mackatack/FCBInfinity/README.md

Behringer FCB1010 modification: FCBInfinity!
===========

This is the home of all the source and schematics for my FCBInfinity project. In this DIY-project I will completely redo the internals of the Behringer FCB1010 midi foot controller. I will add an LCD (Liquid Crystal Display) and some extra buttons and leds to the controller. Hopefully the net result will be an awesome foot pedal that allows me to see realtime data (such as Tuner and Patchnames of my Fractal Audio AxeFx-II).

For more info while I work on this project, see: [http://mackatackblog.wordpress.com](http://mackatackblog.wordpress.com)

FAQ: [FCBInfinity Frequently Asked Questions](https://github.com/mackatack/FCBInfinity/blob/master/faq.md)  
Partlist: [FCBInfinity partlist](https://github.com/mackatack/FCBInfinity/blob/master/Partlist.md)

Did I mention this was open source? :P Here it is: [FCBInfinity sourcecode](https://github.com/mackatack/FCBInfinity/tree/master/Teensyduino/fcbinfinity)  
(Please note that the source code is still in beta phase and will be tidied up greatly soon)
