mackatack/FCBInfinity/Create a PCB/Use A PCB Service/README.md

## Use an (online) PCB service to create a FCBInfinity PCB ##
You can deliver the FCBInfinity Gerber RS274X.zip file to your PCB service. It should have everything they need to create the board for you. The board size is 160x40 mm, double layer.

! more info soon
