mackatack/FCBInfinity/Create a PCB/DIY/FCBInfinity PCB 3D.png

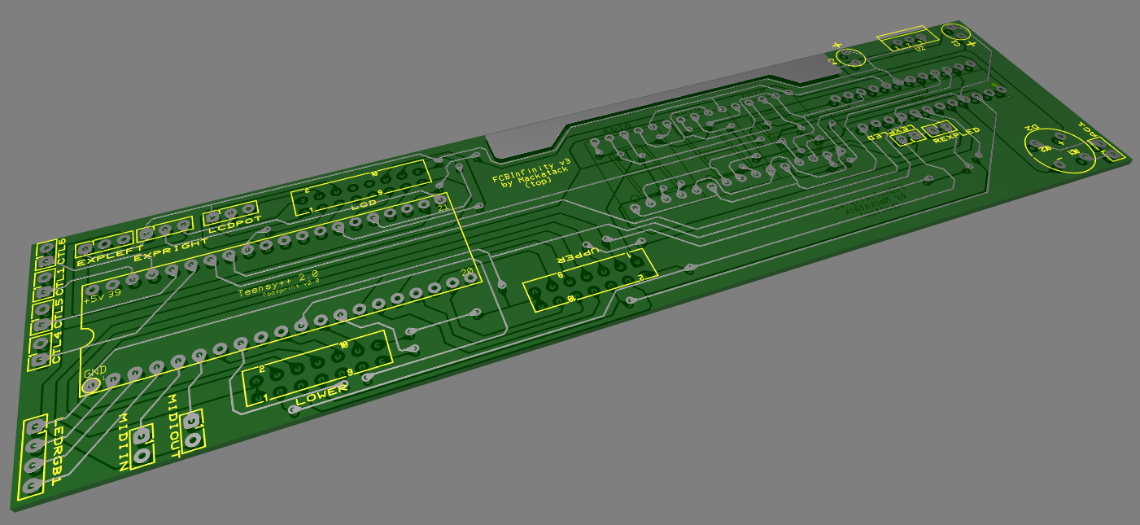
Create a PCB/DIY/FCBInfinity PCB 3D.png
