mackatack/FCBInfinity/Create a PCB/Use A PCB Service/Final PCB.jpg

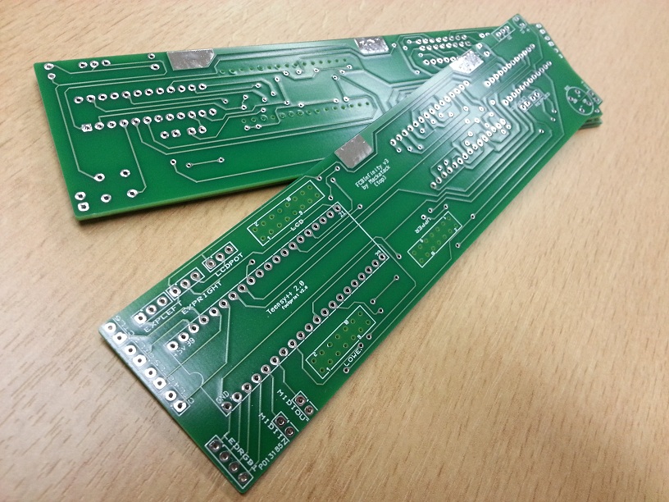
Create a PCB/Use A PCB Service/Final PCB.jpg
