mackatack/FCBInfinity/Partlist.md

# A list of parts that I used for this project: #

## Teensy++ 2.0 ##
Don't forget that you also need an [USB to Mini-USB cable](http://bin.ilsemedia.nl/m/m1dy9dmw0kmz.jpg) to program the Teensy!  
[PJRC.com (International Supplier)](http://www.pjrc.com/store/teensypp_pins.html)  
[PieterFloris (Dutch Supplier)](http://www.pieterfloris.nl/shop/product.php?id_product=356)



----------
## LCD (20x2) ##
[www.conrad.nl](http://www.conrad.nl/ce/nl/product/184748/LC-display-puntmatrix-module-20x2-tekens)  
[datasheet](http://www.produktinfo.conrad.com/datenblaetter/175000-199999/184748-da-01-ml-LCD_Modul_20x2_Zeichen_LED_de_en.pdf)  


----------
## LCD (20x2) Faceplate ##
[www.conrad.nl](http://www.conrad.nl/ce/nl/product/142034/LCD-puntmatrix-module-frontplaat-20x2)  
[datasheet](http://www.produktinfo.conrad.com/datenblaetter/125000-149999/142034-da-01-de-LCD_RAHMEN_FUER_2X20_DISPLAY.pdf)  


----------
## Potmeter ##
**1x** 1kOhm three pin potentiometer for LCD contrast adjust  
[www.conrad.nl](http://www.conrad.nl/ce/nl/product/445536/Potmeter-PC16-mono-10-kOhm-lin)  
[datasheet](http://www.produktinfo.conrad.com/datenblaetter/425000-449999/445536-da-01-en-POTENTIOMETER_PC16_Mono.pdf)



----------
## 7seg LED Digits **(x 3!)** ##
**3x** SC56-11 SRWA RED 14 MM (***Common Kathode!***)  
[www.conrad.nl](http://www.conrad.nl/ce/nl/product/160237/SC56-11-SRWA-ROOD-14-MM-K)  
[datasheet](http://www.produktinfo.conrad.com/datenblaetter/150000-174999/160237-da-01-en-7_SEGMENTANZEIGE_14MM_ROT.pdf)  


----------
## Max7219 Led controller chip ##
**1x** IC MAX7219CNG+ DIP24N  
[www.conrad.nl](http://www.conrad.nl/ce/nl/product/170126/IC-MAX7219CNG-DIP24N)  
[datasheet](http://www.produktinfo.conrad.com/datenblaetter/150000-174999/170126-da-01-en-IC_MAX7219CNG_DIP24N.pdf)



----------
## 7805 5v Power regulator ##
**1x** 7805 5v power regulator in TO 220 form  
[www.conrad.nl](http://www.conrad.nl/ce/nl/product/179205/Spanningsregelaar-7805-ST)  
[datasheet](http://www.produktinfo.conrad.com/datenblaetter/175000-199999/179205-da-01-en-IC_7805_TO_220.pdf)  


----------
## Elco 0.1 uF ##
[www.conrad.nl](http://www.conrad.nl/ce/nl/product/443987/Alu-elco-220uF35V-Low-ESR/SHOP_AREA_17434&promotionareaSearchDetail=005)  



----------
## Elco 0.33 uF ##
[www.conrad.nl](http://www.conrad.nl/ce/nl/product/444020/Alu-elco-470uF35V-Low-ESR/SHOP_AREA_17434&promotionareaSearchDetail=005)  



----------
## Bridge Rectifier ##
[www.conrad.nl](http://www.conrad.nl/ce/nl/product/501433/Silicium-brug-gelijkrichter-B40C1500-2A/6203210&ref=list)



----------
## RGB Red ##  
Optional, if you don't want the stompbox-bank/mode switch, just leave it out.  
[www.conrad.nl](http://www.conrad.nl/ce/nl/product/185353/LED-Full-color-5mm-diffuus/0212268&ref=list)  
[datasheet](http://www.produktinfo.conrad.com/datenblaetter/175000-199999/185353-da-01-en-FULL_COLOR_RGB_LED_DIFFUS.pdf) 

 

----------
## Pushbuttons ##
R13-85A-05 Pushbutton  

These are optional and any other default off, press on push button (non locking) will do. There's room on the PCB to directly connect 4 buttons or leds. On the Teensy there are 8 free ports, so you could add a total of 12 leds or buttons. Or you could just leave these out and only add the LCD to your FCB1010 unit. 

*Here's how I will be using these 12 ports to give you an idea of the possibilities:*  
- A button to control stompbox-bank/mode switching (RGB used as indicator)   
- A button underneath the right ExpPedal to toggle the effect it controls  
- A button for Tap Tempo  
- A led to indicate current Tap Tempo (flashing on Realtime SysEx from AxeFx)  
- A button to enable the Tuner/Mute (no Led needed because Tuner is on the LCD)  
- 7 Free ports :P

[www.conrad.nl](http://www.conrad.nl/ce/nl/product/701083/DRUKKNOP-R13-85A-05)  
[datasheet](http://www.produktinfo.conrad.com/datenblaetter/700000-724999/701083-da-01-en-DRUCKTASTER_R13_85A_05.pdf)  



----------
## Connectors and cables ##
Will update soon
