mackatack/FCBInfinity/Schematics/FCBInfinity Schematic.pdf

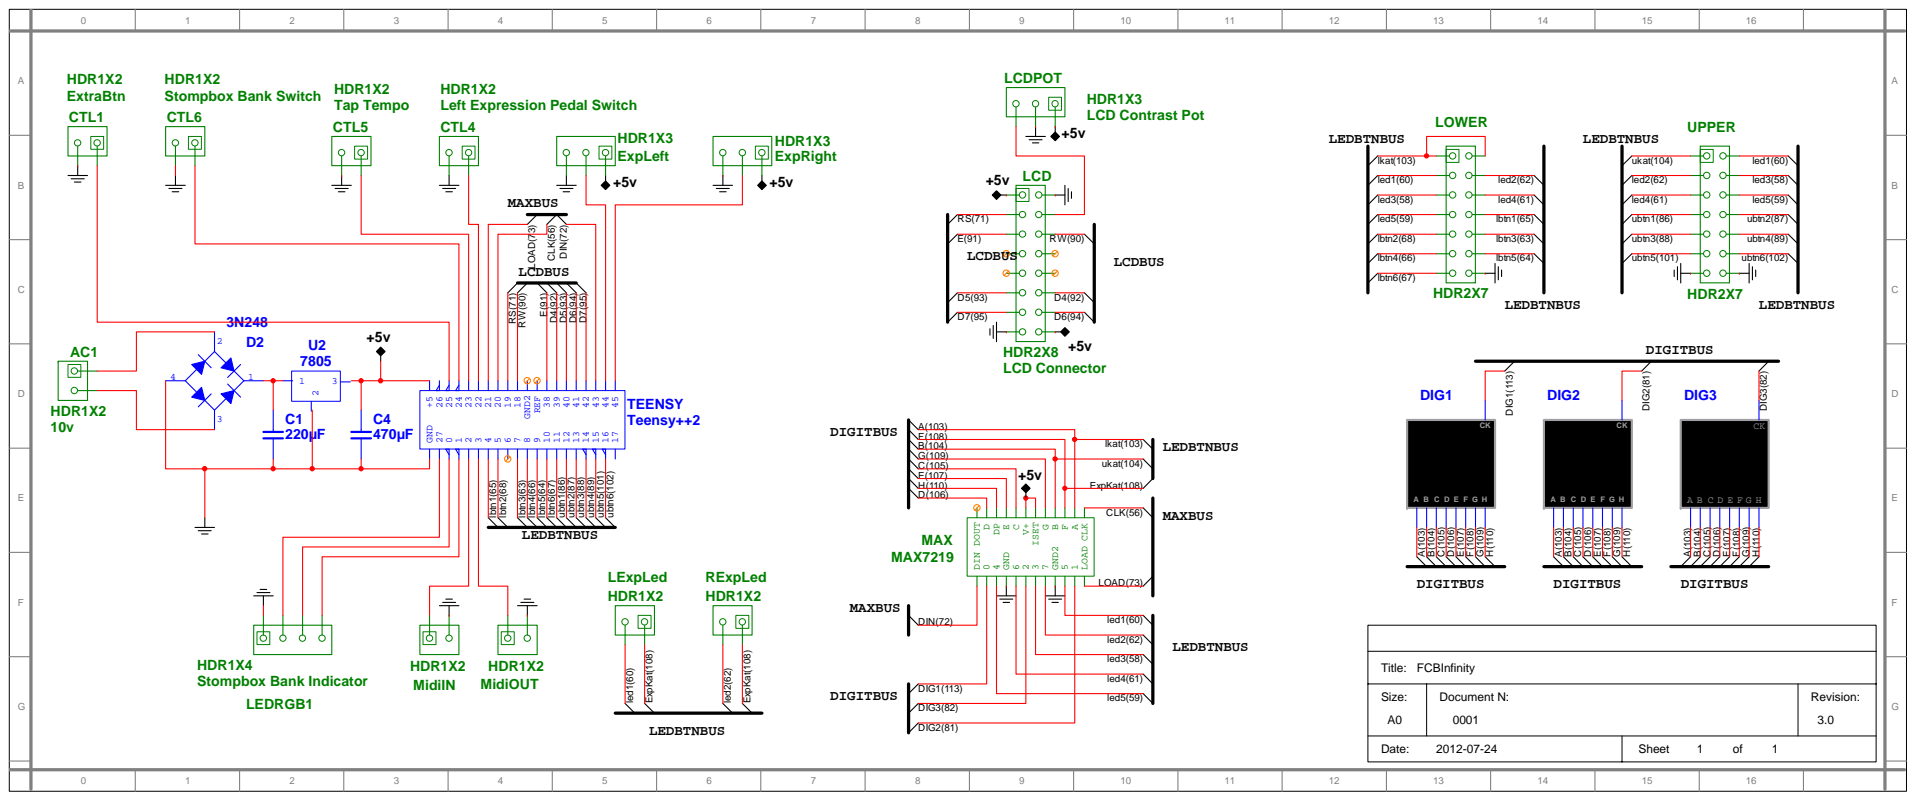
[picture p6: page 1]
TEENSY Teensy++2; GND 270123456789; REF; GND2; MAX; MAX7219; DIN 04; GND 6237; GND2 51; LOAD CLKGBFA; ISETV+EC; DPD DOUT; HDR1X2 10v; LOWER; HDR2X7; UPPER; LEDRGB1; ExpRight; HDR1X3; CTL5; LEDBTNBUS; lkat( 103); led1( 60); led3( 58); led5( 59); led2( 62); led4( 61); lbtn1( 65); lbtn2( 68); lbtn3( 63); lbtn4( 66); lbtn5( 64); lbtn6( 67); ukat( 104); ubtn1( 86); ubtn2( 87); ubtn3( 88); ubtn4( 89); ubtn5( 101); ubtn6( 102); DIG1; AB CDEFG; DIGITBUS; DIG2; DIG1( 113); DIG2( 81); MAXBUS; LCD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

A | HDR1X2 HDR1X2 LCDPOT HDR1X2 HDR1X2 | | | | | | | | | | | | | | | | | A

Stompbox Bank Switch
Tap Tempo CTL6

Left Expression Pedal Switch
CTL4

HDR1X4
Stompbox Bank Indicator

Size: A0 | Document N: 0001 | Revision: 3.0

Date: 2012-07-24 | Sheet 1 of 1
