mackatack/FCBInfinity/Create a PCB/DIY/FCBInfinity PCB Toner Transfer - Copper BOTTOM.pdf

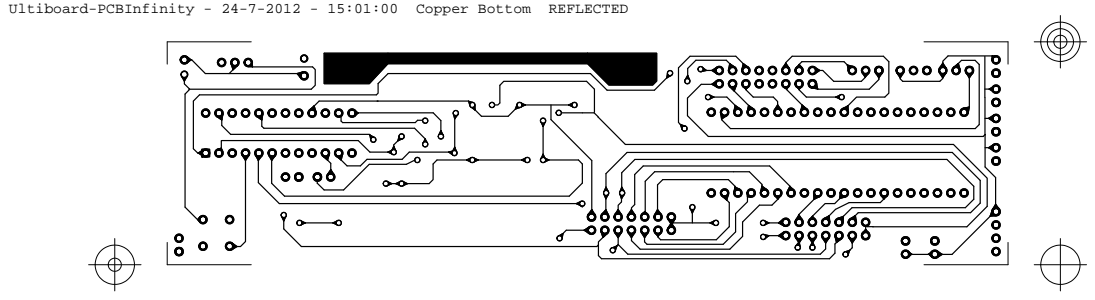
[picture p7: page 1]

Ultiboard-PCBInfinity - 24-7-2012 - 15:01:00 Copper Bottom REFLECTED
