mackatack/FCBInfinity/Create a PCB/DIY/FCBInfinity PCB Toner Transfer - Copper TOP.pdf

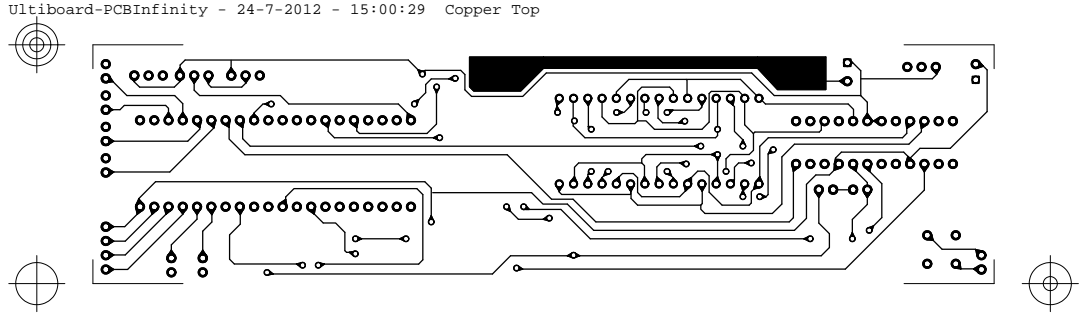
[picture p8: page 1]

Ultiboard-PCBInfinity - 24-7-2012 - 15:00:29 Copper Top
