mackatack/FCBInfinity/(list of files, drawings)

Other design files:
Schematics/Multisim Source/fcbinfinity/Main.ms11
