mackatack/FCBInfinity/(commit log)

2012-07-16 Initial add of the arduino code. VERY much in testing phase at the moment
2012-07-16 Added all the Multisim files and the exported PDFs
    [Main.ms11]
2012-07-24 Updated schematics, relocated some file and added some source code
    [Main.ms11]
2012-07-24 Added readme for the PCBService files
2012-07-26 added final pcb photo
2012-08-01 fixed some identation and optimized a few for loops
    [fcbinfinity.ino, io_AxeMidi.cpp]
2012-08-02 Added a little more documentation and moved some debugging code around. Now also requesting the AxeFx to send the presetname after bootup Button 5 toggles X/Y Button 1-4 switch presets and also take 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
2012-08-02 - Updated the partslist to have the correct values for the input regulator capacitors. - Added commentary to the RGB led and push buttons that they are optional and information how many buttons (or l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
2012-08-02 added more info on the pushbuttons, added a list of buttons and the additional led I will be using in this setup.
2012-08-02 Pins of the RGB led swapped
    [fcbinfinity.h]
2012-08-05 Added the FCBTimerManager, this call allows us to create syncronous timers in the project that call functions after a specified period of time and has options to repeat timers and reschedule them.
2012-08-05 Updated FCBTimerManager to also allow timer deletions.
2012-08-06 Moved a whole lot of code around Now using Timers to detect a connected AxeFx, in case the AxeFx is started after the FCB. Later we will also use these timers to detect if a AxeFx has been disconnect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
2012-08-06 A little bit of documentation on the EffectIDs that are used over the various AxeFx models.
    [AxeFX Effect ID List.csv]
2012-08-07 Timer is using the new AssocLinkedList object
2012-08-07 Added the effectmanager that is responsible for storing the current Effectblock states and has functions to modify the different effect blocks
2012-08-07 After having all sorts of bullshit with midi (messages not arriving etc) I bundled the latest version of the library and all my problems went away!
    [io_AxeMidi.cpp, io_AxeMidi.h, io_MIDI.cpp, io_MIDI.h]
2012-08-09 Added the option to set the status of an ExpressionPedal to handled, so code further down the loop() function doesn't handle the update of the expPedal value.
    [io_ExpPedals.cpp, io_ExpPedals.h]
2012-08-14 Fixed a couple of incorrect links in the install guide
2012-10-19 Added controls for the looper and now handling the WAH/Pitch toggle for Exp1 correctly
    [fcbinfinity.h, fcbinfinity.ino, io_AxeMidi.cpp, io_AxeMidi.h, utils_FCBEffectManager.cpp, utils_FCBEffectManager.h]
2012-10-21 void function doesn't return a value ;)
    [fcbinfinity.ino]
2012-11-28 Committing the current version before we start implementing muting the delay inputs instead of bypassing the delays (so we can use spillovers and such)
2013-01-12 Changed the modes a little so it's easier to switch to looper mode
